cqin5/CS3380/(commit log)

2014-04-17 -AI : all methods included
    -missing compass code
    -this push contains pseudocode that is to be replaced with the compass’
    values/variables
    [sketch_apr03b.ino]
2014-04-19 shortened definitions
    -save memory
    [gps_full_with_servo_simplified.ino]
